ClearGauntlets/ClearGauntlet-PCB/README.md

# ClearGauntlet-PCB
PCB - Schematics Design for VR Gloves

A breakout board for ClearGauntlets, aimed at improving cable management and minifying electronics of VR Gloves.
