ClearGauntlets/ClearGauntlet-PCB/board/lower_v3.kicad_pcb

## KiCad design board/lower_v3.kicad_pcb (2023-03-09)

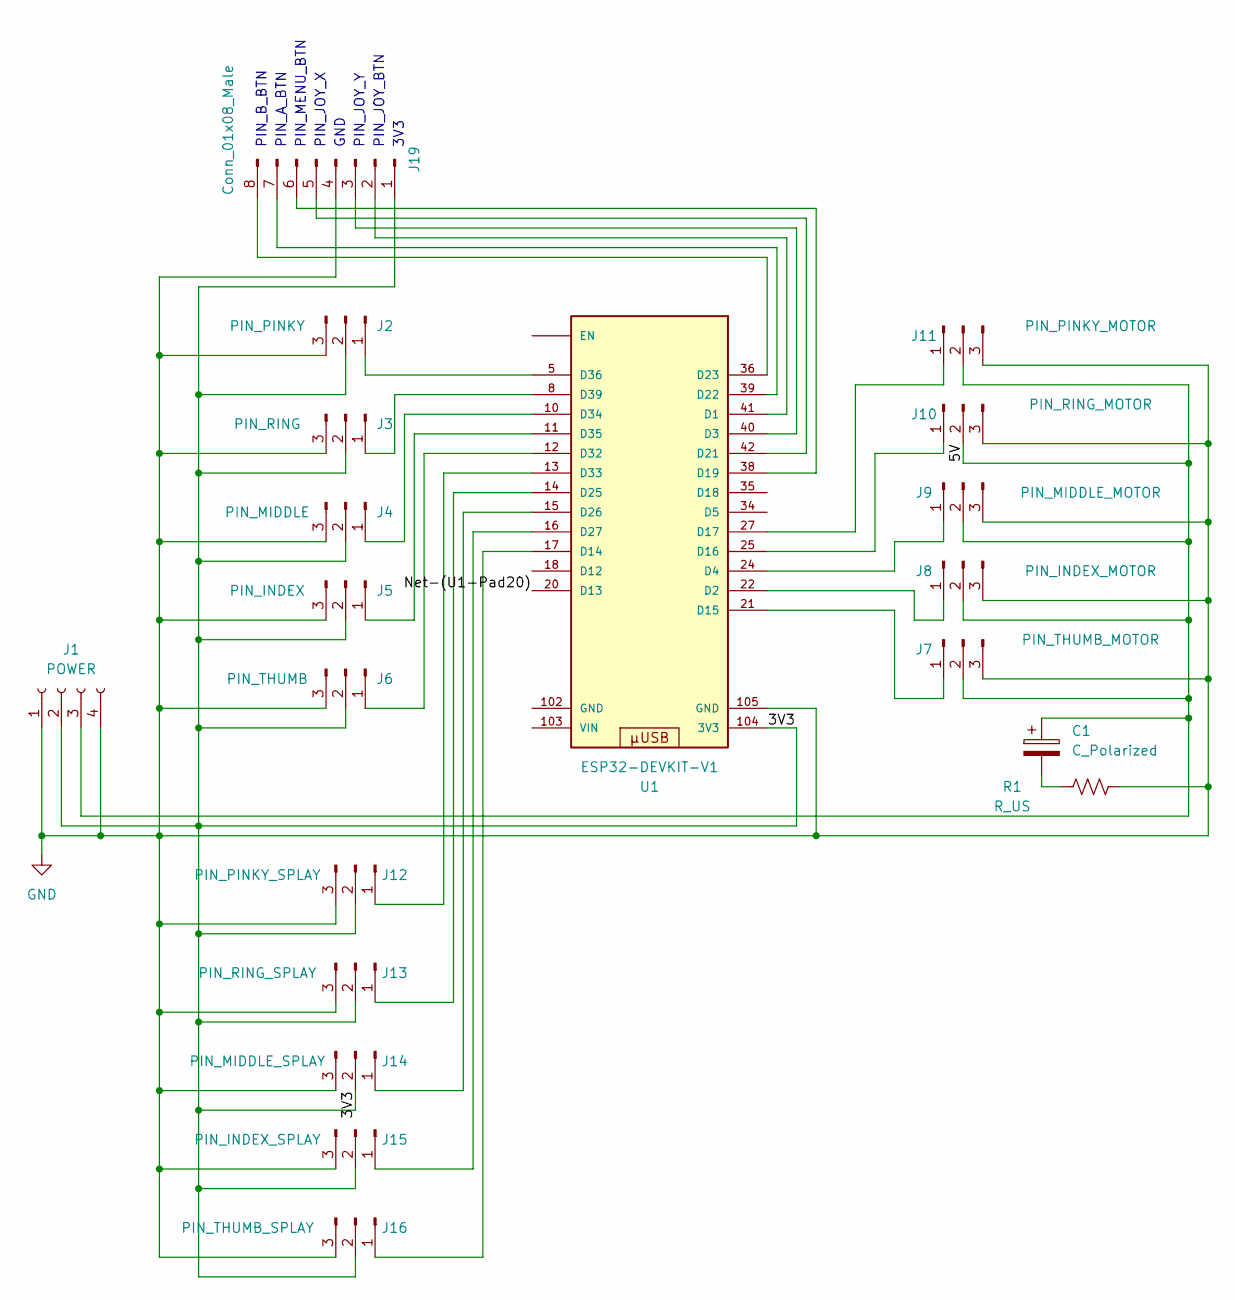
[picture p1: schematic lower_v3.kicad_sch]

Parts:
C1: C_Polarized; CP_Radial_D10.0mm_P5.00mm
J1: POWER; JST_EH_B4B-EH-A_1x04_P2.50mm_Vertical
J2: PIN_PINKY; PinHeader_1x03_P2.54mm_Vertical
J3: PIN_RING; PinHeader_1x03_P2.54mm_Vertical
J4: PIN_MIDDLE; PinHeader_1x03_P2.54mm_Vertical
J5: PIN_INDEX; PinHeader_1x03_P2.54mm_Vertical
J6: PIN_THUMB; PinHeader_1x03_P2.54mm_Vertical
J7: PIN_THUMB_MOTOR; PinHeader_1x03_P2.54mm_Vertical
J8: PIN_INDEX_MOTOR; PinHeader_1x03_P2.54mm_Vertical
J9: PIN_MIDDLE_MOTOR; PinHeader_1x03_P2.54mm_Vertical
J10: PIN_RING_MOTOR; PinHeader_1x03_P2.54mm_Vertical
J11: PIN_PINKY_MOTOR; PinHeader_1x03_P2.54mm_Vertical
J12: PIN_PINKY_SPLAY; PinHeader_1x03_P2.54mm_Vertical
J13: PIN_RING_SPLAY; PinHeader_1x03_P2.54mm_Vertical
J14: PIN_MIDDLE_SPLAY; PinHeader_1x03_P2.54mm_Vertical
J15: PIN_INDEX_SPLAY; PinHeader_1x03_P2.54mm_Vertical
J16: PIN_THUMB_SPLAY; PinHeader_1x03_P2.54mm_Vertical
J19: Conn_01x08_Male; PinSocket_2x04_P2.54mm_Vertical
R1: R_US; R_Axial_DIN0207_L6.3mm_D2.5mm_P10.16mm_Horizontal
U1: ESP32-DEVKIT-V1; MODULE_ESP32_DEVKIT_V1; PARTREV N/A

Connections:
/3V3: J1.2, J2.2, J3.2, J4.2, J5.2, J6.2, J12.2, J13.2, J14.2, J15.2, J16.2, J19.1, U1.104 (3V3)
/5V: C1.1, J1.3, J7.2, J8.2, J9.2, J10.2, J11.2
/Net-(U1-Pad20): U1.20 (D13)
GND: J1.1, J1.4, J2.3, J3.3, J4.3, J5.3, J6.3, J7.3, J8.3, J9.3, J10.3, J11.3, J12.3, J13.3, J14.3, J15.3, J16.3, J19.4, R1.1, U1.105 (GND)
unnamed: C1.2, R1.2
unnamed: J2.1, U1.5 (D36)
unnamed: J3.1, U1.8 (D39)
unnamed: J4.1, U1.10 (D34)
unnamed: J5.1, U1.11 (D35)
unnamed: J6.1, U1.12 (D32)
unnamed: J7.1, U1.21 (D15)
unnamed: J8.1, U1.22 (D2)
unnamed: J9.1, U1.24 (D4)
unnamed: J10.1, U1.25 (D16)
unnamed: J11.1, U1.27 (D17)
unnamed: J12.1, U1.13 (D33)
unnamed: J13.1, U1.14 (D25)
unnamed: J14.1, U1.15 (D26)
unnamed: J15.1, U1.16 (D27)
unnamed: J16.1, U1.17 (D14)
unnamed: J19.2, U1.41 (D1)
unnamed: J19.3, U1.40 (D3)
unnamed: J19.5, U1.42 (D21)
unnamed: J19.6, U1.38 (D19)
unnamed: J19.7, U1.39 (D22)
unnamed: J19.8, U1.36 (D23)

Notes on the sheet:
PIN_JOY_Y
PIN_A_BTN
PIN_JOY_X
PIN_MENU_BTN
GND
PIN_JOY_BTN
3V3
PIN_B_BTN

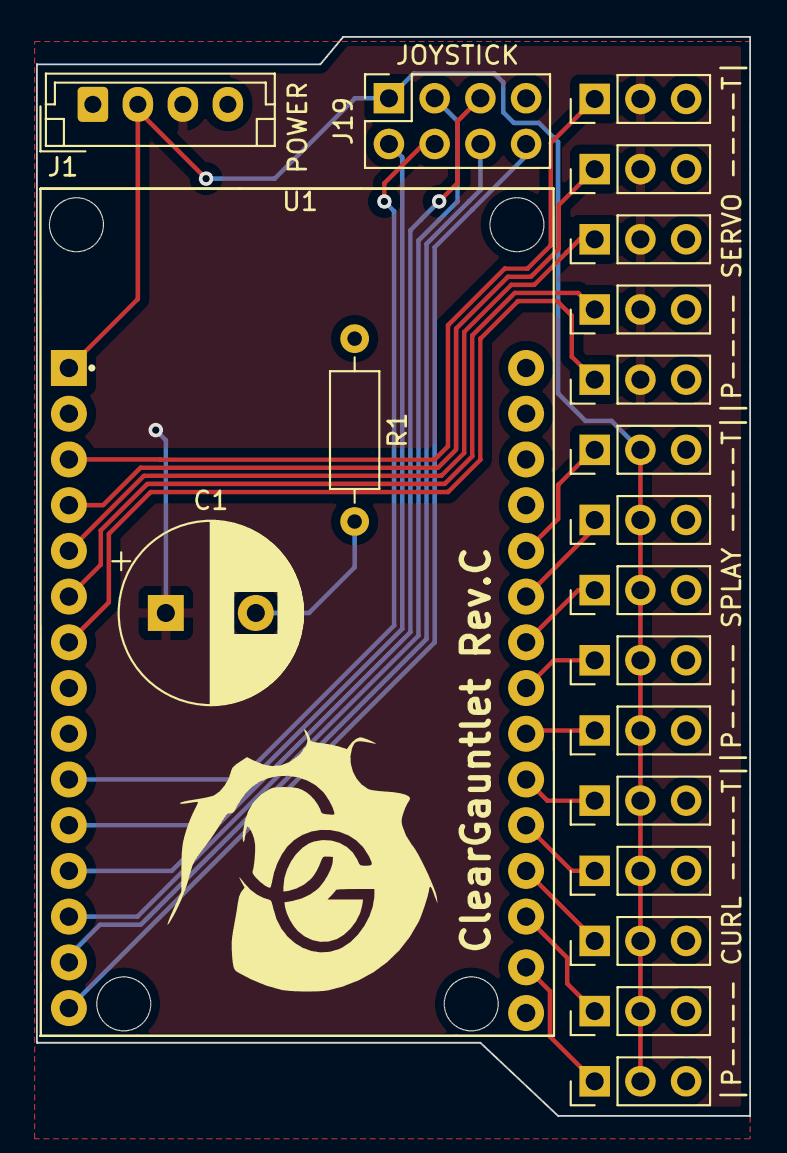
[picture p2: board lower_v3.kicad_pcb from above]

Board: 2 copper layers, 39.6 x 59.9 mm, 20 parts (0 on the bottom side), 25 nets.
