ClearGauntlets/ClearGauntlet-PCB/(threads)

Thread 8 (2023-01-27):

Incorrect pinout/missing pins

WillNilges, 2023-01-27:
Rev A is missing pins required for basic operation of the board. Additionally, the pin pattern for power and ground is incorrect.

The pins needed for basic operation are as follows. These ones need to be surrounded by a 3.3V pin and GND pin
- D32: PIN_THUMB **has 5V pin**
- D35: PIN_INDEX **has 5V pin**
- D34: PIN_MIDDLE **has 5V pin**
- D39: PIN_RING **MISSING**
- D36: PIN_PINKY **MISSING**

These ones need to be surrounded by a 5V pin and GND pin.
- D5: PIN_PINKY_MOTOR **has 3.3V pin**
- D18: PIN_RING_MOTOR **has 3.3V pin**
- D19: PIN_MIDDLE_MOTOR  **has 3.3V pin**
- D21: PIN_INDEX_MOTOR  **has 3.3V pin**
- D17: PIN_THUMB_MOTOR **MISSING**

See the [firmware configuration](https://github.com/LucidVR/lucidgloves/blob/8515b110362a13a2abf119d287870a31e65aa666/firmware/lucidgloves-firmware/lucidgloves-firmware.ino) file in the LucidVR project for more info.

lhn3149, 2023-01-29:
There is a misunderstanding in pins number.
From the schematic symbol I have, the pin ( for example D17. D36,...) does not match your description with my intended use.
My symbol does not have D36, D17.
I put some annotations on the schematics as well as the excel listing all the connections on 2 boards.

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

WillNilges, 2023-01-29:
Gotcha, thanks for updating that.

What I'm saying, though, is that there's several major issues:

1. In the firmware configuration, certain pins are used for certain functions. As a rule, we must maintain feature parity with the lucidVR firmware in order to make cooperation and upstreaming changes as easy as possible, so the pins you are using on these boards are wrong.
2. The positive voltage rails for the servos and potentiometers are flipped. The servos need 5V and the potentiometers need 3.3V
3. There seems to be a surplus of pins on this design. We only need 30 pins (10 signal, 10 ground, 10 power) for the servos and pots, plus an extra two for for the DOME (hypothetically), and this design seems to have redundant pins sprinkled throughout it that make it very difficult to make sense of.
4. Nothing is labeled on the silkscreen, which makes it even more difficult to assemble. While it's possible to reference the diagram to remedy this, you shouldn't have to. Just put the labels on the silkscreen.

WillNilges, 2023-01-29:
One more thing I noticed, your ESP32 symbol is labeled incorrectly. Here's what it should look like:
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

WillNilges, 2023-01-30:
Upon closer inspection, I see the intention with the power rails—it now appears that the signal pins are switched. If you look at the [LucidVR Firmware Config](https://github.com/LucidVR/lucidgloves/blob/8515b110362a13a2abf119d287870a31e65aa666/firmware/lucidgloves-firmware/lucidgloves-firmware.ino), that becomes obvious. All the pots are supposed to be relegated to one row of pins on one side, and the servos on the other, but that's switched. Apart from a few that are straight-up wrong.

**To be abundantly clear: [This file](https://github.com/LucidVR/lucidgloves/blob/8515b110362a13a2abf119d287870a31e65aa666/firmware/lucidgloves-firmware/lucidgloves-firmware.ino) is our source of truth for the signal pins. We must follow this as closely as we can.**

lhn3149, 2023-01-30:
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
Yes, the 5V goes on the top but only connects to 1 pin (for the DOME), the majority is used to power the top plate where all the servos are connected. the 3.3V power is at the bottom and runs (blue wire) across the pins for potentiometers.

Other than that, I think we need to discuss today looking at the board.

WillNilges, 2023-01-30:
The philosophy that I would prefer to follow with this design, if we go with it, is to separate voltage levels. All the 3v3 pins should be on one row, and all the 5v pins should be on the other.

WillNilges, 2023-02-01:
Closed with Revision B (#9 )

Closed 2023-02-01.

Thread 12 (2023-04-26):

Alternate curl/splay connectors

WillNilges, 2023-04-26:
I think it would make for a cleaner build if I alternated the curl and splay connectors for each finger instead of grouping them.

WillNilges, 2023-04-26:
Same probably goes for the servos.
