ClearGauntlets/ClearGauntlet-PCB/(commit log)

2022-10-17 Add files via upload
    initial commit
    [ClearGauntlet.kicad_pcb, ClearGauntlet.kicad_sch]
2022-10-17 PCB updated with footprint
    [ClearGauntlet.kicad_pcb]
2022-10-17 adding PCB updated with schematics
    [ClearGauntlet.kicad_pcb, ClearGauntlet.kicad_sch]
2022-10-24 PCB with wiring
    [ClearGauntlet.kicad_pcb, ClearGauntlet.kicad_sch]
2022-11-06 adding v3
    [ClearGauntlet.kicad_pcb, ClearGauntlet.kicad_sch, ClearGauntlet.step, lower_v3.kicad_pcb, lower_v3.kicad_sch, upper_v3.kicad_pcb, upper_v3.kicad_sch, upper_v3.step]
2022-11-14 Complete Toast PCB
    [lower_v3.kicad_pcb, lower_v3.kicad_sch, toast_upper.STEP, upper_v3.kicad_pcb, upper_v3.kicad_sch]
2022-11-19 Adding clear Proto-board portion for the DOME
    [lower_v3.kicad_sch, upper_v3.kicad_pcb]
2022-11-19 Rev.A Toast Design, fixing connection between 2 boards, adding 3 I/O for the DOME, creating blank proto area for testing
    [lower_v3.kicad_pcb, lower_v3.kicad_sch, upper_v3.kicad_pcb, upper_v3.kicad_sch]
2022-11-22 With OshPark order
    [lower_v3-B_Cu.gbl, lower_v3-B_Mask.gbs, lower_v3-B_Paste.gbp, lower_v3-B_Silkscreen.gbo, lower_v3-Edge_Cuts.gm1, lower_v3-F_Cu.gtl, lower_v3-F_Mask.gts, lower_v3-F_Paste.gtp]
2022-11-23 Add pin detail, fixing layout annotation on board
    [ClearGauntlet.kicad_pcb, ClearGauntlet.kicad_sch, ClearGauntlet.step, PCB_pins_detail.xlsx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]
2023-01-29 Lay out protoboard PCB
    [lower_v3.kicad_sch]
2023-01-30 Add more pins
    [lower_v3.kicad_pcb, lower_v3.kicad_sch]
2023-01-31 Finalize board
    [lower_v3.kicad_pcb, lower_v3.kicad_sch]
2023-01-31 Submit Rev B for fabrication
    [lower_v3.kicad_pcb]
2023-02-01 Rev C
    [lower_v3.kicad_pcb, lower_v3.kicad_sch]
2023-02-10 Locate OpAmp and Photo Diodes
    [lower_v3.kicad_pcb, lower_v3.kicad_sch]
2023-03-08 Combine joystick connector, add C and R
    [lower_v3.kicad_sch]
2023-03-08 RevC RC 1
    [lower_v3.kicad_pcb, lower_v3.kicad_sch]
2023-03-08 Rev C RC 1.1
    Oops wanted to make absolutely sure the ground and 5V planes were
    properly connected
    [lower_v3.kicad_pcb]
2023-03-08 Smallerize resistor
    [lower_v3.kicad_pcb, lower_v3.kicad_sch]
2023-03-08 Fix Joystick port pin layout
    [lower_v3.kicad_pcb]
2023-03-08 Remove via
    [lower_v3.kicad_pcb]
